jharmer95/Garage-RTC/README.md

# Garage-RTC
Project to create a real-time garage control system
