jharmer95/Garage-RTC/Code as DOCX/Embedded Code.docx

# File: GarageRTC.h

/*****************************************************************************

* File: GarageRTC.h

* Description: Implements a real time IoT Garage Door controller. See

* https://github.com/jharmer95/Garage-RTC/ for details on the

* Open GarageRTC project.

* Authors: Daniel Zajac, danzajac@umich.edu

* Jackson Harmer, jharmer@umich.edu

*

*****************************************************************************/

#ifndef GARAGERTC_H_INCLUDE

#define GARAGERTC_H_INCLUDE

#if CONFIG_FREERTOS_UNICORE

# define ARDUINO_RUNNING_CORE 0

#else

# define ARDUINO_RUNNING_CORE 1

#endif

/*****************************************************************************

* Include libraries and references

*

*****************************************************************************/

/*****************************************************************************

* Library: LiquidCrystal_PCF8574.h

* Author: Matthias Hertel www.mathertel.de

* Source: http://www.mathertel.de/Arduino/LiquidCrystal_PCF8574.aspx

* Version: 1.1.0

* Description: A library for driving LiquidCrystal displays (LCD) by using the

* I2C bus and an PCF8574 I2C adapter. This library is derived

* from the original Arduino LiquidCrystal library and uses the

* original Wire library for communication.

*****************************************************************************/

#include <LiquidCrystal_PCF8574.h>

/*****************************************************************************

* Library: WiFi.h

* Author: Hristo Gochkov <hristo@espressif.com>

* Source: https://github.com/espressif/arduino-esp32/tree/master/libraries/WiFi/src

* Version: 1.0

* Description: With this library you can instantiate Servers, Clients and

* send/receive UDP packets through WiFi. The shield can connect

* either to open or encrypted networks (WEP, WPA). The IP

* address can be assigned statically or through a DHCP. The

* library can also manage DNS.

*****************************************************************************/

#include "WiFi.h"

/*****************************************************************************

* Library: AsyncUDP.h

* Author: Me-No-Dev

* Source: https://github.com/me-no-dev/ESPAsyncUDP

* Version: 1.0.0

* Description: Async UDP Library for ESP32

*****************************************************************************/

#include "AsyncUDP.h"

/*****************************************************************************

* Library: esp_system.h

* Author: Hristo Gochkov, Ivan Grokhtkov <hristo@espressif.com>

* Source: https://github.com/espressif/arduino-esp32

* Version: 1.0.2

* Description: ESP32 Board Support, includes FreeRTOS for ESP32. Reference

* below.

*****************************************************************************/

#include "esp_system.h"

/*****************************************************************************

* Library: FreeRTOS Copyright (C) 2015

* Author: Real Time Engineers Ltd.

* Source: http://www.FreeRTOS.org

* Version: FreeRTOS V8.2.0

* Description: FreeRTOS provides completely free yet professionally developed,

* robust, strictly quality controlled, supported, and cross

* platform software that is more than just the market leader, it

* s the industry's de facto standard.

*****************************************************************************/

/*****************************************************************************

* Library: WIFI_AP.h

* Author: Daniel Zajac, Jackson Harmer

* Source: https://github.com/jharmer95/Garage-RTC/

* Version: 1.0.0

* Description: Contains WIFI credentials

*****************************************************************************/

#include "WIFI_AP.h"

/*****************************************************************************

* Defines to make addressing Pins easier

*****************************************************************************/

// Defines to make the code more readable

#define PIN_TEMP A7

#define PIN_CO A6

#define PIN_CO_DIG 13

#define BUTTON_ALARM 5

#define BUTTON_DOOR 4

#define BUTTON_STOP 0

#define BUTTON_LIGHT 15

#define LIMSW_UP 27

#define LIMSW_DOWN 12

#define LIMSW_OBS 14

#define RELAY_DOOR 32

#define RELAY_ALARM 33

#define RELAY_LIGHT 25

#define RELAY_AUX 26

// Flagging bits for timing or other debug

#define DEBUG_T1 23

#define DEBUG_T2 19

#define DEBUG_T3 18

#define DEBUG_T4 2

#define DP_OPEN 0

#define DP_CLOSE 1

#define DP_STOP 2

#define DP_MOVE 3

int outputPins[] = { RELAY_DOOR, RELAY_ALARM, RELAY_LIGHT, RELAY_AUX, DEBUG_T1, DEBUG_T2, DEBUG_T3, DEBUG_T4 };

/*****************************************************************************

* Static system parameters

*

*****************************************************************************/

#define LOW_PRI_TASK_DELAY 1000 // Low priority loop time in mS

#define MED_PRI_TASK_DELAY 100 // Medium Priority Task Loop in mS

#define HIGH_PRI_TASK_DELAY 10 // High Prioirty Task Loop in mS

#define CO_WARMUP 90000 // worst case CO sensor warm-up time

#define DEBOUNCEMS 10 // debounce time in milliseconds

#define MAXSWS 7 // Max number of switches in the system

#define MAXIO 8 // Max number of IO pins

#define BTNHOLDMIL 1000 // Hold time for the garage door button

#define HIGHTEMP 95 // High temperature alarm limit

#define LOWTEMP 50 // Low Temperature alarm limit

#define TEMPHYST 5 // Temp Hysteresis

#define HIGHCO 20 // High CO Limit

#define MEDCO 10 // High CO Limit

#define COHYST 5 // CO Hysteresis

#define SERIALSPEED 115200 // Serial Baud Rate

#define WDTIMEOUT 5000 // Watch Dog Timeout

/*****************************************************************************

* Function prototypes

*

*****************************************************************************/

// Tasks

void TaskReadSensors(void* pvParameters);

void TaskUpdateDisplay(void* pvParameters);

void TaskPriorityMachines(void* pvParameters);

void TaskNetwork(void* pvParameters);

void TaskWatchdog(void* pvParameters);

// general

void initWatchdog();

void debounce(int pinIndex, bool bouncing[], int buttonState[], int stopTime[]);

void initNetwork(AsyncUDP& udp);

/*****************************************************************************

* Global Variables

*

*****************************************************************************/

// custom char since '\' does not exist on the display

static byte customBackslash[8] = { 0b00000, 0b10000, 0b01000, 0b00100, 0b00010, 0b00001, 0b00000, 0b00000 };

static int g_switches[MAXSWS] = { BUTTON_ALARM, BUTTON_DOOR, BUTTON_STOP, BUTTON_LIGHT, LIMSW_UP, LIMSW_DOWN, LIMSW_OBS };

// Needs to match order above.

enum SWITCH_INDEX

{

ALARM,

DOOR,

STOP,

LIGHT,

UP,

DOWN,

OBS

};

byte g_WatchDogBowl = 0; // Watchdog Feed bowl

portMUX_TYPE g_wdMutex; // Mux to protect the watchdog bowl

portMUX_TYPE g_sharedMemMutex; // mutex to protect the shared globals

portMUX_TYPE g_serialMutex; // Mux to protect the serial device

byte g_buttonState[MAXSWS] = { 1, 1, 1, 1, 1, 1, 1 };

bool g_alarmState = false;

bool g_doorMovingState = false;

bool g_lightOnState = false;

bool g_Connected = false;

byte g_doorPosition = 0;

// Shared Variables

float g_temp = 23.4;

float g_co = 0.0;

byte g_webCmd = 0;

byte g_coState = 0;

// converting the g_coState to a string

const char* g_coStateStr[3] = { "LOW", "WARN", "HIGH" };

bool g_firstRun = true; // Indicating the system is just starting up

bool g_heating = true; // Indicates the CO sensor is still heating

#endif

# File: GarageRTC.INO

/*****************************************************************************

File: GarageRTC.ino

Description: Implements a real time IoT Garage Door controller. See

https://github.com/jharmer95/Garage-RTC/ for details on the

Open GarageRTC project.

Authors: Daniel Zajac, danzajac@umich.edu

Jackson Harmer, jharmer@umich.edu

*****************************************************************************/

#include "GarageRTC.h"

// configure global for the LCD port

LiquidCrystal_PCF8574 lcd(0x27);

/*****************************************************************************

Function: void setup( void )

Description: This function is run once at startup after reset. It sets up

hardware and initializes the system.

*****************************************************************************/

void setup()

{

// initialize serial communication

Serial.begin(SERIALSPEED);

// Setup the serial mutex

g_serialMutex = portMUX_INITIALIZER_UNLOCKED;

// initalize digital output pins

for (int i = 0; i < MAXIO; ++i)

{

digitalWrite(outputPins[i], HIGH); // set the pins for inital pullup

pinMode(outputPins[i], OUTPUT); // Assign them the output state

}

// initalize digital input pins

for (int i = 0; i < MAXSWS; ++i)

{

pinMode(g_switches[i], INPUT_PULLUP); // Setup as input with pull up

}

// setup the display

lcd.begin(20, 4); // setup the LCD dims

lcd.setBacklight(128); // set the backlighting

lcd.home(); // send the cursor home

lcd.clear(); // clear the display

// create a new character, display missing backslash

lcd.createChar(1, customBackslash);

// set the static display elements

lcd.setCursor(0, 0);

lcd.print("T: NET: ");

lcd.setCursor(0, 1);

lcd.print("C: SYSTEM: ");

lcd.setCursor(0, 2);

lcd.print(" LIGHT: ");

lcd.setCursor(0, 3);

lcd.print(" DOOR: ");

// Share Memory mutex

g_sharedMemMutex = portMUX_INITIALIZER_UNLOCKED;

// g_WatchDogBowl mutex

g_wdMutex = portMUX_INITIALIZER_UNLOCKED;

xTaskCreatePinnedToCore(TaskReadSensors, "TaskReadSensors", 1024, NULL, 3, // Priority 3 is the highest

NULL, ARDUINO_RUNNING_CORE);

xTaskCreatePinnedToCore(TaskUpdateDisplay, "TaskUpdateDisplay", 2048, // Stack size

NULL, 1, // Priority

NULL, ARDUINO_RUNNING_CORE);

xTaskCreatePinnedToCore(TaskPriorityMachines, "TaskPriorityMachines", 1024, // Stack size

NULL, 2, // Priority

NULL, ARDUINO_RUNNING_CORE);

xTaskCreatePinnedToCore(TaskNetwork, "TaskNetwork", 4096, // Stack size

NULL, 1, // Priority

NULL, ARDUINO_RUNNING_CORE);

xTaskCreatePinnedToCore(TaskWatchdog, "TaskWatchdog", 1024, // Stack size

NULL, 1, // Priority

NULL, ARDUINO_RUNNING_CORE);

}

/*****************************************************************************

Function: void loop( void )

Description: This function is run during idle cycles but does no useful

work since everything is done in tasks.

*****************************************************************************/

void loop()

{

// Empty. Things are done in Tasks.

}

/*****************************************************************************

Function: void initNetwork( AsyncUDP &udp )

AsyncUDP &udp - handle to the UDP connection

Description: This function is run once at startup after reset. It sets up

wifi network.

Referecnes: Modifed from example code provided with the WiFi Library.

See GarageRTC.h for the complete reference.

*****************************************************************************/

void initNetwork(AsyncUDP& udp)

{

WiFi.mode(WIFI_STA); // Setup the wifi Mode

WiFi.begin(g_ssid, g_password); // Setup the SSID and Password

bool connected = false; // local for connected

// Wait for aconnection

if (WiFi.waitForConnectResult() != WL_CONNECTED)

{

// if we do not get a connection, let the serial know

taskENTER_CRITICAL(&g_serialMutex);

Serial.println("WiFi Did not connect");

taskEXIT_CRITICAL(&g_serialMutex);

connected = false;

}

else

{

// otherwise we connected

connected = true;

// setup the port to listen to

if (udp.listen(1234))

{

// print out the IP we obtained.

taskENTER_CRITICAL(&g_serialMutex);

Serial.print("UDP Listening on IP: ");

Serial.println(WiFi.localIP());

taskEXIT_CRITICAL(&g_serialMutex);

}

}

// write the connection status to the shared variable

taskENTER_CRITICAL(&g_sharedMemMutex);

g_Connected = connected;

taskEXIT_CRITICAL(&g_sharedMemMutex);

}

/*****************************************************************************

Function: void TaskReadSensors( void* pvParameters )

void* pvParameters - Paramaters passed in as part of the

scheduler configuration for this task.

Description: Sensor Processing Tasks - This task is responsible for fetching,

converting values from the sensors and making the results

available other tasks. In general, this task will perform the

following functions:

• Fetch values from sensors

• Scale/Convert values

• Read/debounce switches

• Store values to memory

• Update shared variables

*****************************************************************************/

void TaskReadSensors(void* pvParameters)

{

(void)pvParameters;

TickType_t xLastWakeTime;

bool bouncing[MAXSWS];

byte buttonState[MAXSWS];

byte stopTime[MAXSWS];

for (int i = 0; i < MAXSWS; i++)

bouncing[i] = false;

while (true)

{

// Macro that expands to schedule the next wake-up time and then

// sleep the task until the next schedule wake-up.

vTaskDelayUntil(&xLastWakeTime, 10);

// read Analogs - this is the only task that reads so no need to

// provide exclusive access.

int sensorValueT = analogRead(PIN_TEMP);

int sensorValueCO = analogRead(PIN_CO);

// read digitals:

for (int i = 0; i < MAXSWS; ++i)

{

debounce(i, bouncing, buttonState, stopTime);

}

// print out the value you read:

float temp_buf = 0.0637 * sensorValueT - 40.116;

float co_buf = 0.0527 * sensorValueCO - 72.728;

// write back variables to shared globals. Protect with

// mutex to avoid race condition with another thread

taskENTER_CRITICAL(&g_sharedMemMutex);

g_temp = temp_buf;

g_co = co_buf;

for (int i = 0; i < MAXSWS; i++)

g_buttonState[i] = buttonState[i];

taskEXIT_CRITICAL(&g_sharedMemMutex);

// set my bit in the watchdog

taskENTER_CRITICAL(&g_wdMutex);

g_WatchDogBowl = g_WatchDogBowl | 0x1;

taskEXIT_CRITICAL(&g_wdMutex);

}

}

/*****************************************************************************

Function: void debounce( int pinIndex )

int pinIndex - The index of the pin to debounce.

bool bouncing[] - Array of bools indicating if that switch is

currently debouncing.

int buttonState[] - Array of current button states.

int stopTime[] - array of times to stop debouncing.

Description: Debounces the pin for DEBOUNCEMS milliseconds

*****************************************************************************/

void debounce(int pinIndex, bool bouncing[], byte buttonState[], byte stopTime[])

{

// only read if we are in a debounce

if (!bouncing[pinIndex])

{

int current = digitalRead(g_switches[pinIndex]);

// have we have seen an edge?

if (buttonState[pinIndex] != current)

{

//startTimer and signal debouncing

stopTime[pinIndex] = esp_log_timestamp() + DEBOUNCEMS;

bouncing[pinIndex] = true;

}

}

if (bouncing && (esp_log_timestamp() > stopTime[pinIndex])) // see if we are past the bounce window

{

//save the value

buttonState[pinIndex] = digitalRead(g_switches[pinIndex]);

//reset the bouncing

bouncing[pinIndex] = false;

}

}

/*****************************************************************************

Function: void TaskUpdateDisplay( void* pvParameters )

void* pvParameters - Paramaters passed in as part of the

scheduler configuration for this task.

Description: LCD Display Task - This task is responsible for updating the

local display. In general, this task will perform the

following functions:

• Fetch values from memory

• Post readings or status to the display

• Update the displays including:

o Temperature

o CO Level

o Connection Status

o System state

Note: The LCD selected is very slow to update so we do not

redraw the entire display each cycle, only updating the chars

that have changed.

*****************************************************************************/

void TaskUpdateDisplay(void* pvParameters)

{

(void)pvParameters;

TickType_t xLastWakeTime;

char TEMPmsg[6];

char DOORmsg[5];

int twiddle = 0; // the running indicator on the display

// local buffers for shared memory

float temp;

float co;

bool doorMovingState;

bool lightOnState;

byte upButtonState;

byte downButtonState;

bool alarmState;

bool connected;

byte doorPosition;

byte coState;

while (true)

{

// Macro that expands to schedule the next wake-up time and then

// sleep the task until the next schedule wake-up.

vTaskDelayUntil(&xLastWakeTime, 500);

// buffer in the shared memory

taskENTER_CRITICAL(&g_sharedMemMutex);

temp = g_temp;

doorPosition = g_doorPosition;

lightOnState = g_lightOnState;

upButtonState = g_buttonState[UP];

downButtonState = g_buttonState[DOWN];

alarmState = g_alarmState;

connected = g_Connected;

doorMovingState = g_doorMovingState;

taskEXIT_CRITICAL(&g_sharedMemMutex);

lcd.setCursor(0, 3);

switch (twiddle)

{

case 0:

lcd.write('|');

break;

case 1:

lcd.write('/');

break;

case 2:

lcd.write('-');

break;

case 3:

lcd.write(byte(1));

break;

}

twiddle = (twiddle + 1) % 4;

// Create temprate string from float

dtostrf(temp, 5, 1, TEMPmsg);

lcd.setCursor(2, 0);

lcd.print(TEMPmsg);

// update the CO content

if (co > HIGHCO)

{

lcd.setCursor(2, 1);

lcd.print("HIGH");

coState = 2;

}

else if (co > MEDCO)

{

lcd.setCursor(2, 1);

lcd.print("WARN");

coState = 1;

}

else

{

lcd.setCursor(2, 1);

lcd.print("LOW ");

coState = 0;

}

// Update the door Position

if (doorMovingState)

{

lcd.setCursor(15, 3);

lcd.print("MOVE ");

doorPosition = DP_MOVE;

}

else if (upButtonState == LOW)

{

lcd.setCursor(15, 3);

lcd.print("OPEN ");

doorPosition = DP_OPEN;

}

else if (downButtonState == LOW)

{

lcd.setCursor(15, 3);

lcd.print("CLOSE");

doorPosition = DP_CLOSE;

}

else

{

lcd.setCursor(15, 3);

lcd.print("STOP ");

doorPosition = DP_STOP;

}

// Update the light state

if (lightOnState)

{

lcd.setCursor(15, 2);

lcd.print("ON ");

}

else

{

lcd.setCursor(15, 2);

lcd.print("OFF");

}

// update the alarm state

if (alarmState)

{

lcd.setCursor(15, 1);

lcd.print("ALARM");

}

else

{

lcd.setCursor(15, 1);

lcd.print("OK ");

}

// update the network state

if (connected)

{

lcd.setCursor(15, 0);

lcd.print("OK ");

}

else

{

lcd.setCursor(15, 1);

lcd.print("NONE");

}

//write back global door state and co state for web

taskENTER_CRITICAL(&g_sharedMemMutex);

g_doorPosition = doorPosition;

g_coState = coState;

taskEXIT_CRITICAL(&g_sharedMemMutex);

// set my bit in the watchdog

taskENTER_CRITICAL(&g_wdMutex);

g_coState = coState;

g_WatchDogBowl = g_WatchDogBowl | 0x2;

taskEXIT_CRITICAL(&g_wdMutex);

}

}

/*****************************************************************************

Function: void TaskNetwork( void* pvParameters )

void* pvParameters - Paramaters passed in as part of the

scheduler configuration for this task.

Description: Handles network communication tasks

Referecnes: Modifed from example code provided with the esp32 Library.

See GarageRTC.h for the complete reference.

*****************************************************************************/

void TaskNetwork(void* pvParameters)

{

(void)pvParameters;

t TickType_t xLastWakeTime;

char wifiBuff[255] = "";

char tempBuff[6];

char coBuff[6];

char doorPosStr[6];

AsyncUDP udp;

// local buffers for shared memory

float temp;

float co;

bool lightOnState;

bool connected;

int doorPosition;

bool alarmState;

byte coState;

xLastWakeTime = xTaskGetTickCount();

while (true)

{

// Macro that expands to schedule the next wake-up time and then

// sleep the task until the next schedule wake-up.

vTaskDelayUntil(&xLastWakeTime, 500);

// buffer in the shared memory

taskENTER_CRITICAL(&g_sharedMemMutex);

temp = g_temp;

co = g_co;

lightOnState = g_lightOnState;

doorPosition = g_doorPosition;

connected = g_Connected;

alarmState = g_alarmState;

coState = g_coState;

taskEXIT_CRITICAL(&g_sharedMemMutex);

if (!connected)

initNetwork(udp);

if (connected)

{

// have to load via dtosttrf due to sprintf bug

dtostrf(temp, 5, 1, tempBuff);

dtostrf(co, 5, 1, coBuff);

sprintf(wifiBuff,

"[{\"name\": \"alarmStatus\", \"value\": \"%s\"}, {\"name\": \"doorStatus\", \"value\": \"%d\"}, {\"name\": "

"\"lightStatus\", \"value\": \"%s\"}, {\"name\": \"tempStatus\", \"value\": \"%s\"}, {\"name\": \"coStatus\", \"value\": "

"\"%s\"}]",

alarmState ? "True" : "False", doorPosition, lightOnState ? "ON" : "OFF", tempBuff, g_coStateStr[coState]);

udp.broadcast(wifiBuff);

}

udp.onPacket([](AsyncUDPPacket packet) {

if (packet.length() == 7)

{

byte value = (packet.data()[5]);

#ifdef DEBBUG

Serial.print("value = ");

Serial.print(value, HEX);

Serial.print("\n");

#endif

taskENTER_CRITICAL(&g_sharedMemMutex);

g_webCmd = value;

taskEXIT_CRITICAL(&g_sharedMemMutex);

}

#ifdef DEBBUG

Serial.print("UDP Packet Type: ");

Serial.print(packet.isBroadcast() ? "Broadcast" : packet.isMulticast() ? "Multicast" : "Unicast");

Serial.print(", From: ");

Serial.print(packet.remoteIP());

Serial.print(":");

Serial.print(packet.remotePort());

Serial.print(", To: ");

Serial.print(packet.localIP());

Serial.print(":");

Serial.print(packet.localPort());

Serial.print(", Length: ");

Serial.print(packet.length());

Serial.print(", Data: ");

Serial.write(packet.data(), packet.length());

Serial.println();

//reply to the client

packet.printf("Got %u bytes of data", packet.length());

#endif

});

// set my bit in the watchdog

taskENTER_CRITICAL(&g_wdMutex);

g_WatchDogBowl = g_WatchDogBowl | 0x4;

taskEXIT_CRITICAL(&g_wdMutex);

}

}

/*****************************************************************************

Function: void TaskPriorityMachines( void* pvParameters )

void* pvParameters - Paramaters passed in as part of the

scheduler configuration for this task.

Description: This task is responsible monitoring door position, obstacle

detection, and starting or stopping movement. In general,

this task will perform the following functions:

• Maintain Door state

• Maintain direction state

• Start/Stop door movement

• Monitor obstacle detection

Referecnes: Modifed from example code provided with the WiFi Library.

See GarageRTC.h for the complete reference.

*****************************************************************************/

void TaskPriorityMachines(void* pvParameters)

{

(void)pvParameters;

TickType_t xLastWakeTime;

// state machine state vars

byte lightState = 0;

byte doorState = 0;

byte alarmState = 0;

int buttonHoldTime;

xLastWakeTime = xTaskGetTickCount();

// local buffers for global variables

float temp;

float co;

bool doorMovingState;

byte lightButtonState;

byte alarmButtonState;

byte doorButtonState;

byte upButtonState;

byte downButtonState;

byte stopButtonState;

byte obsButtonState;

bool lightOnState;

while (true)

{

// Macro that expands to schedule the next wake-up time and then

// sleep the task until the next schedule wake-up.

vTaskDelayUntil(&xLastWakeTime, MED_PRI_TASK_DELAY);

// buffer in the shared memory

taskENTER_CRITICAL(&g_sharedMemMutex);

temp = g_temp;

co = g_co;

lightButtonState = g_buttonState[LIGHT] & ~(g_webCmd >> 2);

alarmButtonState = g_buttonState[ALARM] & ~(g_webCmd & 0x1);

doorButtonState = g_buttonState[DOOR] & ~(g_webCmd >> 1);

upButtonState = g_buttonState[UP];

downButtonState = g_buttonState[DOWN];

stopButtonState = g_buttonState[STOP] & ~(g_webCmd >> 1);

obsButtonState = g_buttonState[OBS];

taskEXIT_CRITICAL(&g_sharedMemMutex);

// light State machine (on, off)

switch (lightState)

{

case 0:

if (lightButtonState == LOW)

{ // switch relay ON

// switch LED ON

digitalWrite(RELAY_LIGHT, LOW);

lightOnState = true;

lightState = 1;

}

break;

case 1:

if (lightButtonState == HIGH)

{

lightState = 2;

}

break;

case 2:

if (lightButtonState == LOW)

{ // switch relay OFF

// switch LED OFF

digitalWrite(RELAY_LIGHT, HIGH);

lightOnState = false;

lightState = 3;

}

break;

case 3:

if (lightButtonState == HIGH)

{

lightState = 0;

}

break;

}

// Door Control State Machine

switch (doorState)

{

case 0:

if (doorButtonState == LOW) // someone pressed the button

{

buttonHoldTime = esp_log_timestamp() + BTNHOLDMIL;

digitalWrite(RELAY_DOOR, LOW);

doorMovingState = true;

doorState = 1;

}

break;

case 1: // hold the button for some time to start moving

if (esp_log_timestamp() > buttonHoldTime)

{

digitalWrite(RELAY_DOOR, HIGH);

doorState = 2;

}

break;

case 2: // clear the limit switch

if (((upButtonState == HIGH) && (downButtonState == HIGH)) || (stopButtonState == LOW) || (obsButtonState == LOW))

{

doorState = 3;

}

break;

case 3: // moving

if ((upButtonState == LOW) || (downButtonState == LOW) || (stopButtonState == LOW)

|| (obsButtonState == LOW)) // Limit switch Hit

{

buttonHoldTime = esp_log_timestamp() + BTNHOLDMIL;

digitalWrite(RELAY_DOOR, LOW);

doorState = 4;

}

break;

case 4: // stop moving

if (esp_log_timestamp() > buttonHoldTime)

{

digitalWrite(RELAY_DOOR, HIGH);

doorMovingState = false;

doorState = 0;

}

break;

}

// alarm state machine

switch (alarmState)

{

case 0: // idle

if ((temp > HIGHTEMP) || (temp < LOWTEMP) || (co > HIGHCO))

{ // ALARM condition

digitalWrite(RELAY_ALARM, LOW);

alarmState = 1;

}

break;

case 1: // ALARM

if ((temp < HIGHTEMP - TEMPHYST) && (temp > LOWTEMP + TEMPHYST) && (co < HIGHCO - COHYST))

{ // ALARM condition clearing

digitalWrite(RELAY_ALARM, HIGH);

alarmState = 0;

}

else if (alarmButtonState == LOW)

{ // Someone manually cleared the alarm

digitalWrite(RELAY_ALARM, HIGH);

}

break;

}

// write back global variables

taskENTER_CRITICAL(&g_sharedMemMutex);

g_doorMovingState = doorMovingState;

g_lightOnState = lightOnState;

g_alarmState = alarmState;

g_webCmd = 0; // clear the web command

taskEXIT_CRITICAL(&g_sharedMemMutex);

// set my bit in the watchdog

taskENTER_CRITICAL(&g_wdMutex);

g_WatchDogBowl = g_WatchDogBowl | 0x8;

taskEXIT_CRITICAL(&g_wdMutex);

}

}

/*****************************************************************************

Function: void IRAM_ATTR resetModule( void )

Description: Interrupt service routine for watchdog timer

Referecnes: Modifed from example code provided with the ESP32 library.

See GarageRTC.h for the complete reference.

*****************************************************************************/

void IRAM_ATTR resetModule()

{

esp_restart(); // if called, trigger a systems reset

}

/*****************************************************************************

Function: void TaskWatchdog( void* pvParameters )

void* pvParameters - Paramaters passed in as part of the

scheduler configuration for this task.

Description: This task is responsible monitoring the watchdog bowl and

ensuring all tasks are running. If a task fails to update

its bit in the bowl, the timer will eventually elapse and

reset the device.

Referecnes: Modifed from example code provided with the ESP32 library.

See GarageRTC.h for the complete reference.

*****************************************************************************/

void TaskWatchdog(void* pvParameters)

{

(void)pvParameters;

TickType_t xLastWakeTime;

byte g_WatchDogBowl_buff = 0;

// configure the watchdog timer

const int wdtTimeout = WDTIMEOUT; //time in ms to trigger the watchdog

hw_timer_t* timer = NULL;

timer = timerBegin(0, 80, true); //timer 0, div 80

timerAttachInterrupt(timer, &resetModule, true); //attach callback

timerAlarmWrite(timer, wdtTimeout * 1000, false); //set time in us

timerAlarmEnable(timer); //enable interrupt

xLastWakeTime = xTaskGetTickCount();

// Check to see that the watchdog is being fed by all tasks

// no task is slower than the idle task

while (true)

{

// Macro that expands to schedule the next wake-up time and then

// sleep the task until the next schedule wake-up.

vTaskDelayUntil(&xLastWakeTime, 1500);

taskENTER_CRITICAL(&g_wdMutex);

if (g_WatchDogBowl == 0xF)

{

timerWrite(timer, 0); //reset timer (feed watchdog)

}

g_WatchDogBowl = 0; // clear the bowl

taskEXIT_CRITICAL(&g_wdMutex);

}

}

# File: WIFI_AP.h

/*****************************************************************************

* File: WIFI_AP.ino

* Description: Configures the AP globals.

* Authors: Daniel Zajac, danzajac@umich.edu

* Jackson Harmer, jharmer@umich.edu

*

*****************************************************************************/

#ifndef WIFI_AP_H_INCLUDE

#define WIFI_AP_H_INCLUDE

const char* g_ssid = "ssid";

const char* g_password = "password";

#endif
