jharmer95/Garage-RTC/Schematic v1.0.pdf

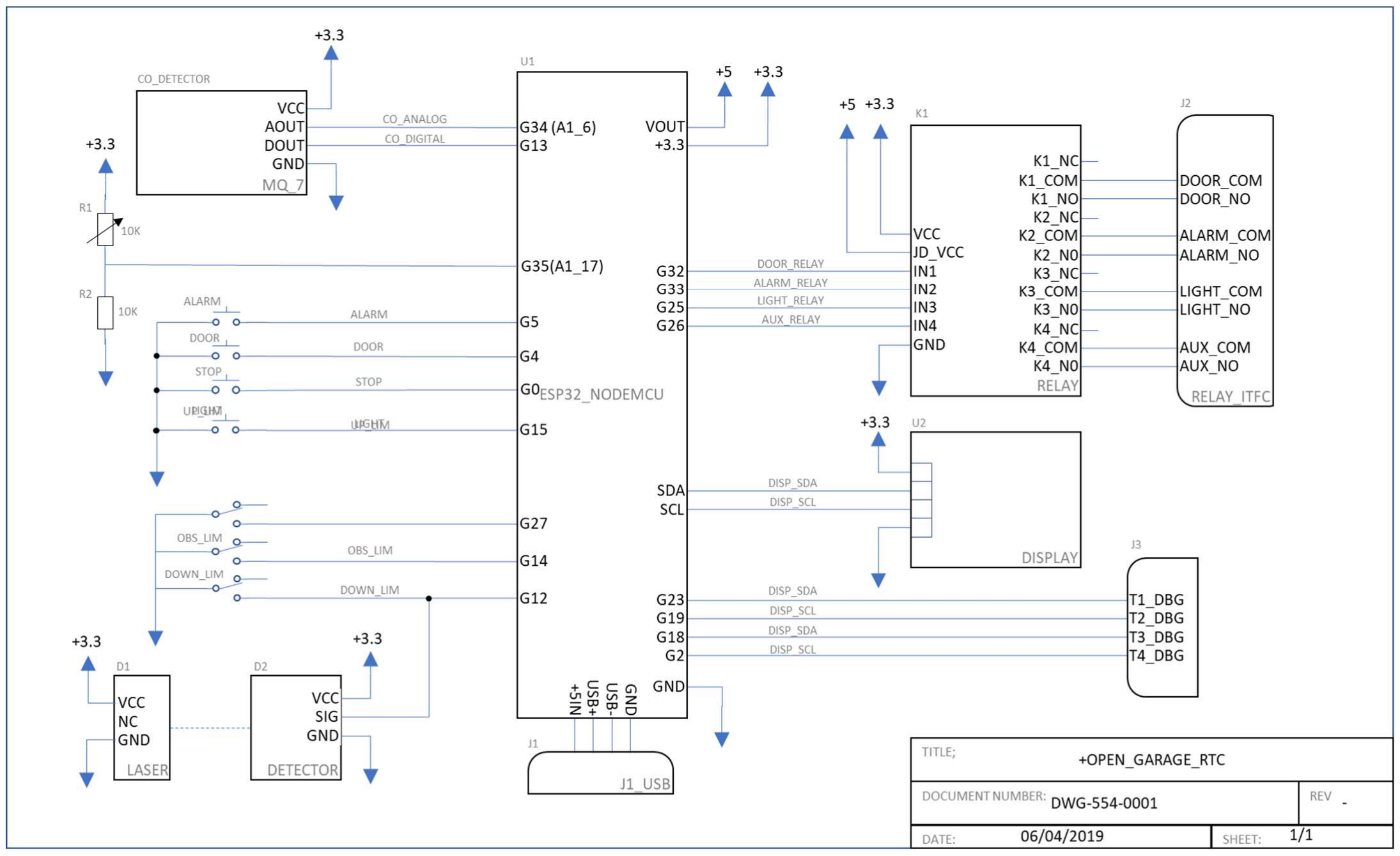
[picture p22: page 1]
