jharmer95/Garage-RTC/(commit log)

2019-04-03 Add files via upload
    Alarm, obstacle, working. Fixed bug with Door opening and limit switch triggered.
    [GarageRTC.h, GarageRTC.ino]
2019-04-03 Add files via upload
    Fix missing scheduling in front of the sample task.
    [GarageRTC.h, GarageRTC.ino]
2019-04-05 Added Watchdog.
    Each task puts a piece of kibble in the bowl. Should see 4 pieces in the bowl. If not, reset after 1.5 seconds.
    [GarageRTC.h, GarageRTC.ino]
2019-04-06 Updated flask web server with socketio callbacks
2019-04-14 Adding Schematic
2019-04-19 More deadcode cleanup, network fixes, added refes
    [GarageRTC.h, GarageRTC.ino]
2019-04-20 Refactor, clean up, and fix web comms.
    [GarageRTC.h, GarageRTC.ino]
